SimonFerrand/BIOREACTOR/README.md

# 🧪 BIOREACTOR Projects

## 🔬 Featured Projects

### 🧫 Bioreactor Control System  
<p align="center">
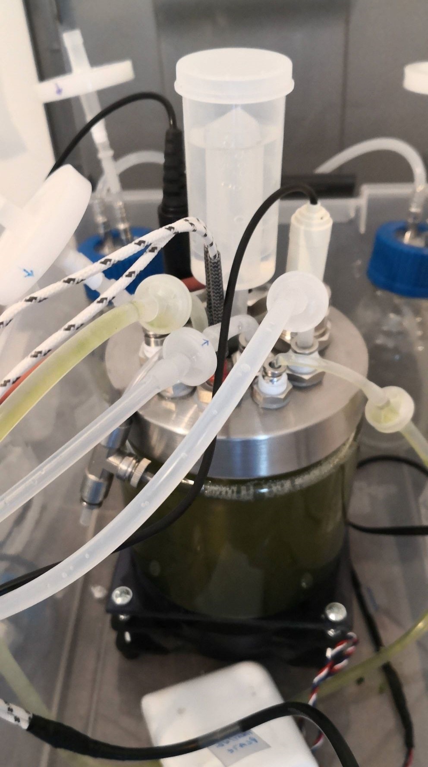
[picture p1: integration/HETEROTROPHIC/XS/docs/photo_bioreactor.jpg]
Bioreactor
  
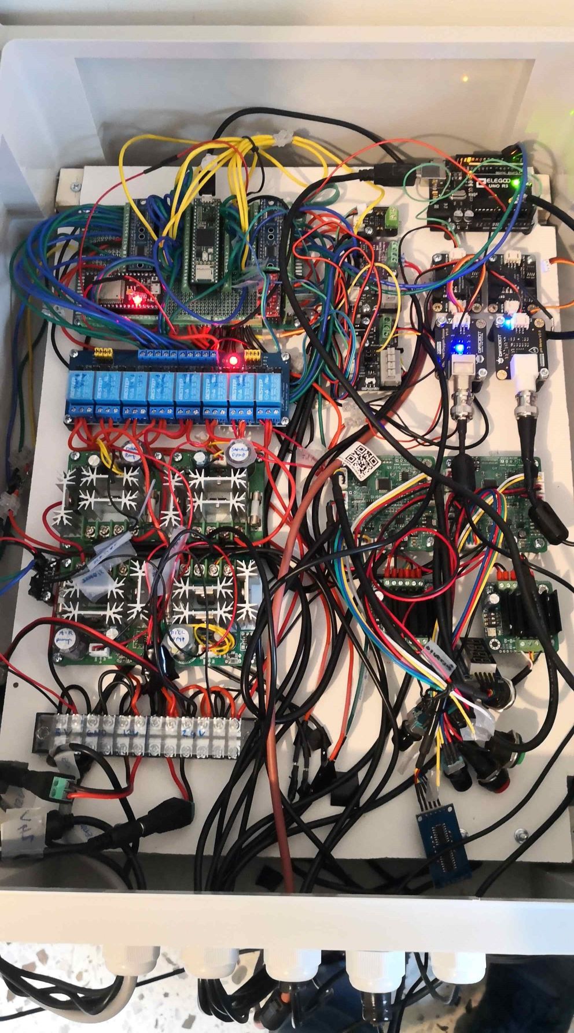
[picture p2: integration/HETEROTROPHIC/XS/docs/photo_cabinet.jpg]
Cabinet
  
</p>

<br>

A control system for managing biological processes through automated monitoring and regulation of key parameters. 

#### Key features:  
- 🧫 Sterilizable system (Autoclave 121°C, Chemical sensors)
- 🌡️ Temperature control (15-40°C)  
- ⚗️ pH regulation (5.0-8.5)  
- 💨 Dissolved oxygen management  
- 🔬 Optical density monitoring
- 📊 Real-time monitoring  
- 💾 Data logging and visualization  
- 🖥️ Web-based control interface  

📖 **[View Full Documentation →](/integration/HETEROTROPHIC/XS/README.md)**  

---

<br>

### 🌊 Water Heater Control  
<p align="center">
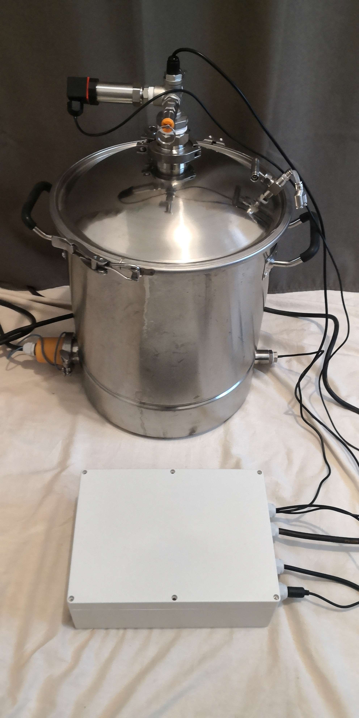
[picture p3: integration/PROCESS/WATER_HEATER/docs/photo1.jpg]
  
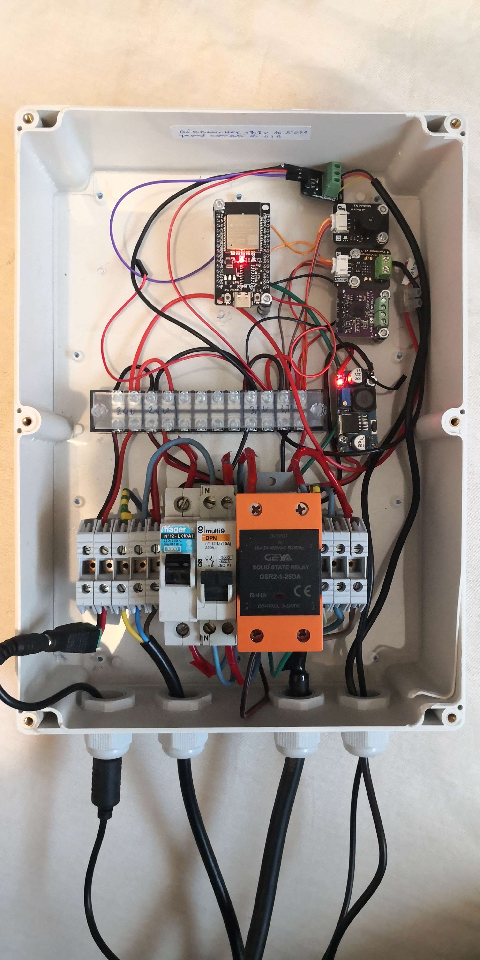
[picture p4: integration/PROCESS/WATER_HEATER/docs/photo2.jpg]
  
</p>

A water heater control system based on ESP32, designed for cleaning and sterilization processes.  

#### Key features:  
- 🎯 PID-based temperature control  
- 📈 Pressure monitoring and safety systems  
- 🔄 Clean-In-Place (CIP) automation  
- 🌐 Web interface and MQTT integration  
- 📡 Real-time data streaming  

📖 **[View Full Documentation →](/integration/PROCESS/WATER_HEATER/README.md)**  

---

<br>

## 📂 Repository Structure  

- /development: Individual component development and testing
- /integration: Complete integrated systems (featured above)
- /docs: Project documentation and resources

---

<br>

## 📝 License  
MIT License 

---
