SimonFerrand/BIOREACTOR/integration/HETEROTROPHIC/XS/requirement.txt

PID_v1
OneWire
DallasTemperature
Adafruit_MAX31865
Adafruit_MCP4725
DFRobot_PH
ArduinoJson
ezTime
Adafruit_MCP4728
NTPClient
AsyncMqttClient //  https://github.com/marvinroger/async-mqtt-client
AsyncTCP  // https://github.com/me-no-dev/AsyncTCP
Ticker
ESPAsyncTCP
ElegantOTA
CircularBuffer
ESPAsyncWebServer //https://github.com/me-no-dev/ESPAsyncWebServer
