SimonFerrand/BIOREACTOR/integration/HETEROTROPHIC/XS/docs/diagram/architectur_diagram.png

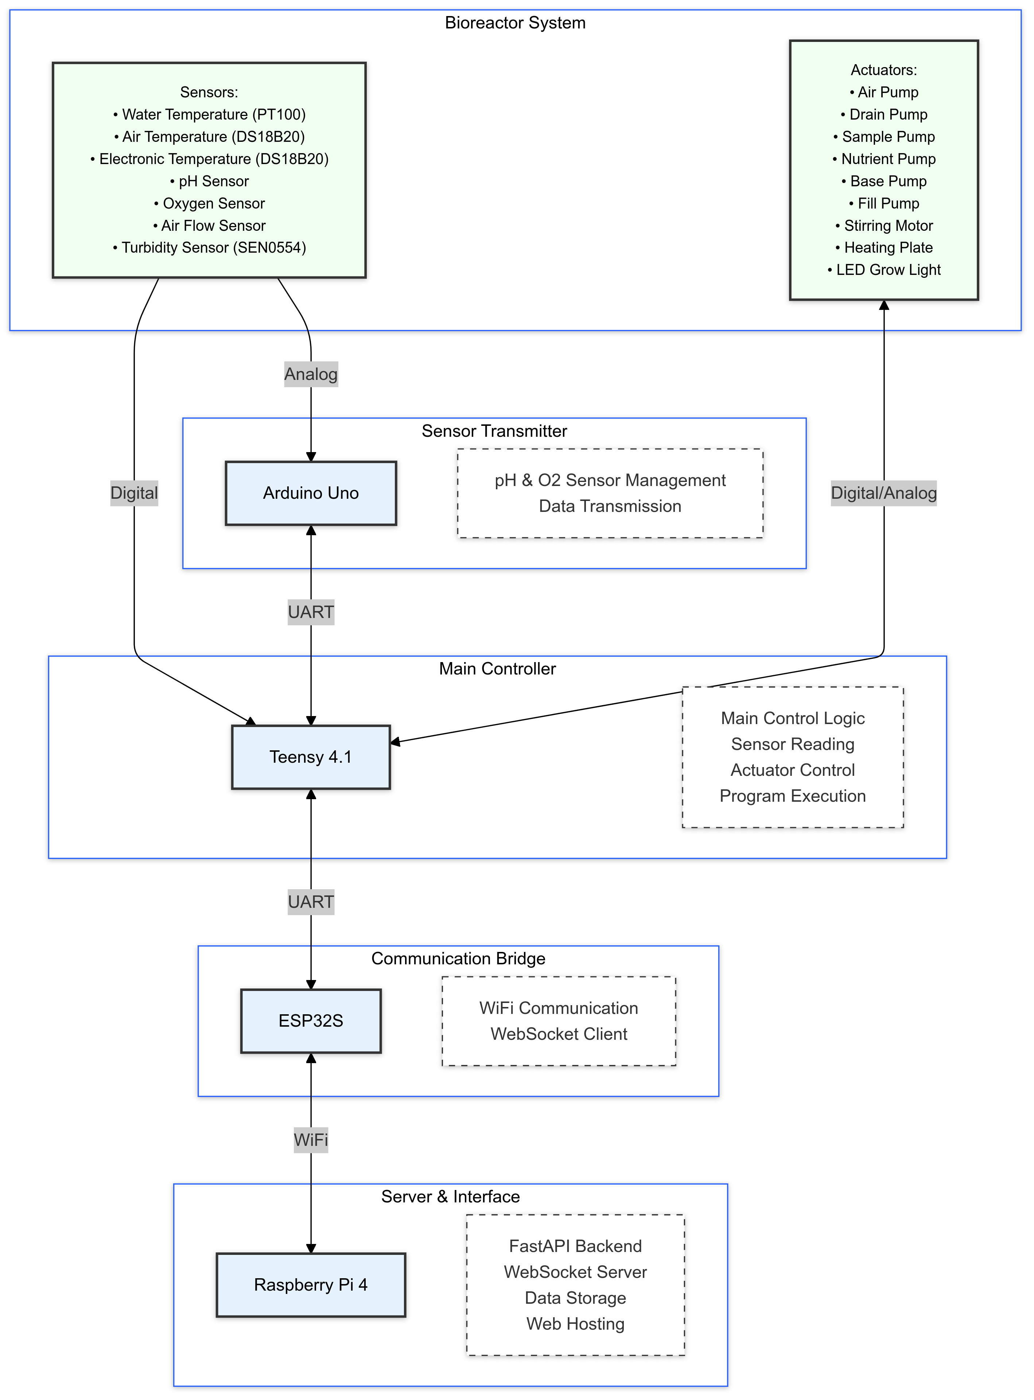
integration/HETEROTROPHIC/XS/docs/diagram/architectur_diagram.png
