SimonFerrand/BIOREACTOR/integration/PROCESS/WATER_HEATER/docs/data_page.PNG

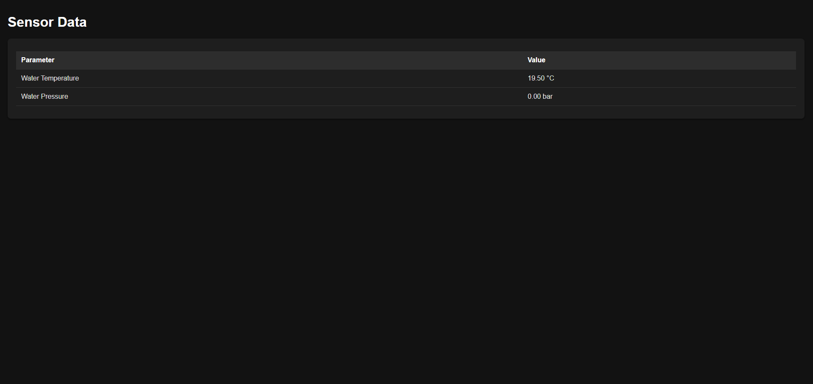
integration/PROCESS/WATER_HEATER/docs/data_page.PNG
