SimonFerrand/BIOREACTOR/integration/PROCESS/WATER_HEATER/docs/OAT_page.PNG

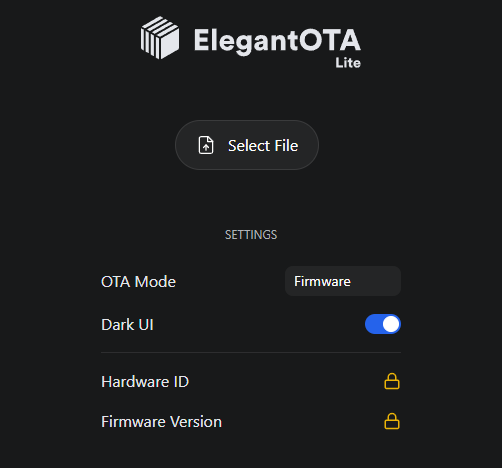
integration/PROCESS/WATER_HEATER/docs/OAT_page.PNG
