SimonFerrand/BIOREACTOR/integration/SERVER/raspberry_pi/ServerFastAPI/ServerFastAPI/architecture.png

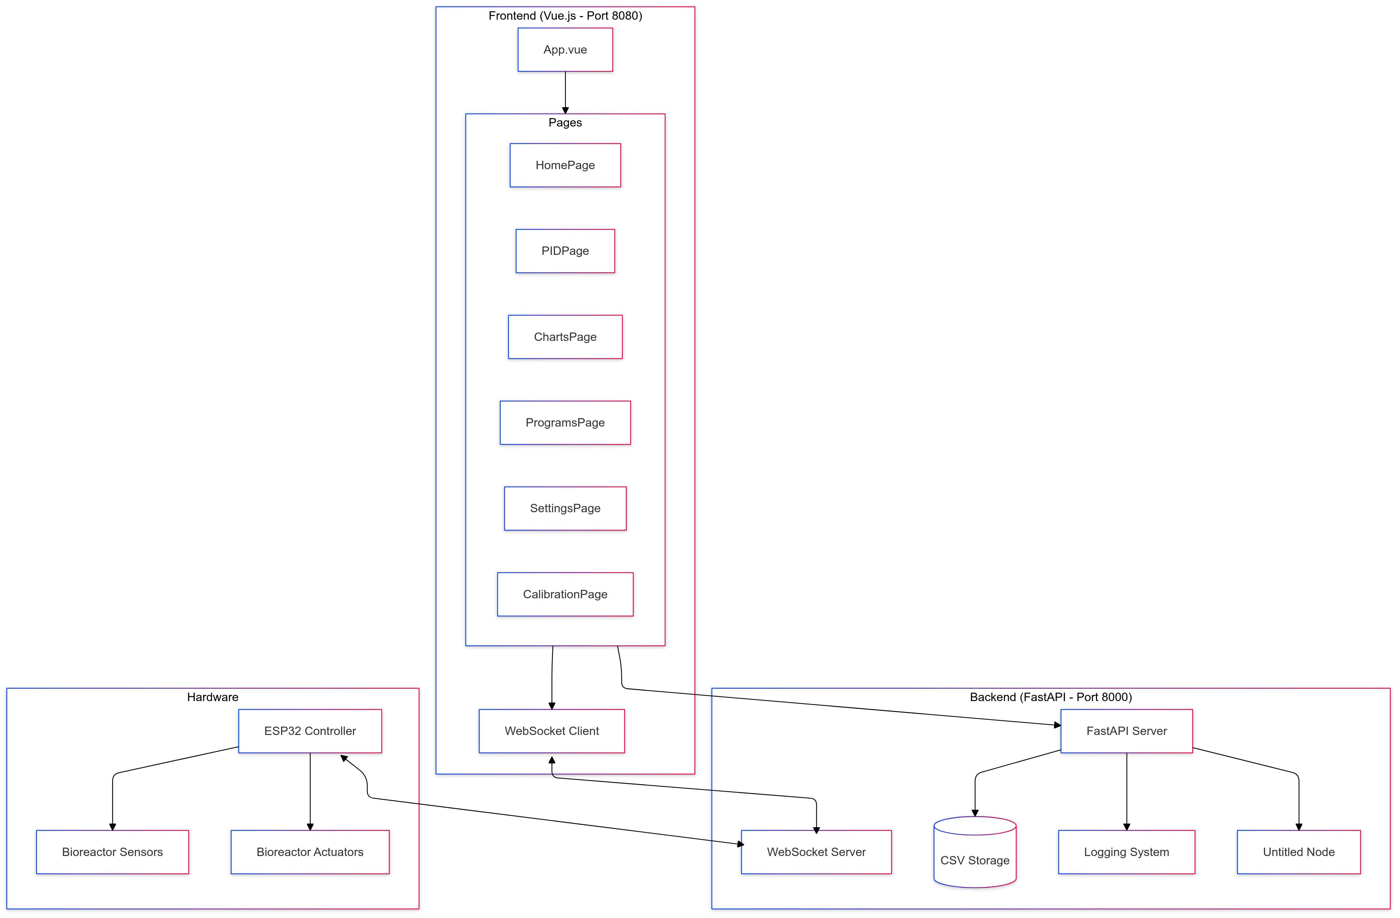
integration/SERVER/raspberry_pi/ServerFastAPI/ServerFastAPI/architecture.png
