SimonFerrand/BIOREACTOR/integration/SERVER/raspberry_pi/ServerFastAPI/install.txt

sudo groupadd sharedgroup
sudo usermod -aG sharedgroup pi
sudo chown -R pi:sharedgroup /Raspberry
sudo chmod -R 2775 /Raspberry

sudo nano /etc/samba/smb.conf
:
[Raspberry]
path = /Raspberry
writeable = yes
create mask = 0777
directory mask = 0777
public = yes
force group = sharedgroup

sudo systemctl restart smbd

npm install plotly.js-dist
pip install pandas pyarrow fastparquet

npm install plotly.js-dist --save
npm install plotly.js-dist@latest
npm install

rm -rf node_modules
rm package-lock.json
npm install

npm install webpack --save-dev
