SimonFerrand/BIOREACTOR/(threads)

Thread 1 (2024-06-07):

Problems with Apache2 Configuration and SSL Authorization

SimonFerrand, 2024-06-07:
Description:
I am facing issues with the Apache2 server configuration, specifically with SSL authorization. Despite numerous attempts, I am unable to resolve the situation. Previously, I managed to get Apache2 working with HTTPS using OpenSSL, but now I can't seem to replicate that success.

Before formatting, I was able to make Apache2 work with HTTPS, but only with OpenSSL. I had trouble properly copying the certificates to the ESP of my Arduino. Now, even though I think I have successfully installed the frontend, the authorization issues persist.

Attached is a txt file of the console showing the errors encountered.[
[cmd.txt](https://github.com/user-attachments/files/15725038/cmd.txt)
](url)

Thread 4 (2024-08-29):

Stack Overflow - SRAM too small

SimonFerrand, 2024-08-29:
I've noticed that above 63%, or at least 67% of SRAM used, there seems to be a stackoverflow problem: the Periodic Event log doesn't print all the JSON. This is problematic because the data is not saved on the server.

One of the solutions for not MinMaxing all my code and allowing me to evolve it would be to migrate to Teensy 4.1.

SimonFerrand, 2024-10-10:
Migration to the Teensy 4.1, which has significantly more SRAM than the Arduino Mega, helped resolve this stack overflow issue.

Closed 2024-10-10.

Thread 5 (2024-11-20):

Compile Arduino Sketch - Error

SimonFerrand, 2024-11-20:
Run mkdir ./build_dir
  mkdir ./build_dir
  arduino-cli compile --fqbn arduino:avr:mega --output-dir ./build_dir ./integration/arduino_mega/Main/Main.ino
  shell: /usr/bin/bash --noprofile --norc -e -o pipefail {0}
Can't open sketch: no such file or directory: /home/runner/work/BIOREACTOR/BIOREACTOR/integration/arduino_mega/Main/Main.ino
Error: Process completed with exit code 1.

=> The architecture of the file has changed
