SimonFerrand/BIOREACTOR/integration/HETEROTROPHIC/XS/teensy/Main/DCPump.h

/*
 * DCPump.h
 * This file defines a class for controlling DC pumps using PWM, a relay, and a motor speed controller.
 * The class implements the ActuatorInterface and provides methods to control the pump with a specified
 * minimum PWM value. This is useful for controlling various types of DC pumps, such as air pumps and liquid drain pumps.
 *
 * Physical modules used:
 * - Relay module
 * - PW1VA01 PWM to Voltage converter
 * - Motor speed controller
 * - DC pump (air pump or liquid drain pump)
 */

#ifndef DCPUMP_H
#define DCPUMP_H

#include "ActuatorInterface.h"
#include <Arduino.h>
#include "QuadChannelDACController.h"

class DCPump : public ActuatorInterface {
public:
    /*
     * Constructor for DCPump.
     * @param pwmPin: The pin connected to the PWM input of the pump.
     * @param relayPin: The pin connected to the relay controlling the pump's power.
     * @param minPWM: The minimum PWM value required to run the pump.
     * @param name: Identifier for the pump (for debugging purposes).
     */
    DCPump(int channel, int relayPin, int minPWM, const char* name);

    /*
     * Method to initialize the pump.
     * This method is called to set up the pump before it's first used.
     */
    void begin() override;

    /*
     * Method to control the pump.
     * @param state: Boolean indicating whether the pump should be on or off.
     * @param value: Integer value to control the speed of the pump.
     */
    void control(bool state, int value) override;

    /*
     * Method to check if the pump is on.
     * @return Boolean indicating if the pump is on.
     */
    bool isOn() const override;

    /*
     * Method to get the name of the pump.
     * @return The name of the pump.
     */
    const char* getName() const override { return _name; }

    /*
     * Method to get the volume of liquid removed by the pump.
     * @return The volume removed in liters.
     */
    float getVolumeAdded() const { return _volumeAdded; }

    /*
     * Method to reset the volume removed counter.
     */
    void resetVolumeAdded() { _volumeAdded = 0; }

    int getCurrentValue() const override;

private:
    int _channel;    
    int _relayPin;  // Relay pin
    int _minPWM;    // Minimum PWM value
    const char* _name;
    bool _status; // Track the state of the pump
    int _currentValue;
    float _volumeAdded;
    float _volumeRemoved; // Track the volume removed by the pump
    
};

#endif
