SimonFerrand/BIOREACTOR/integration/HETEROTROPHIC/XS/teensy/Main/QuadChannelDACController.h

// Development for DAC "MCP4728"

// QuadChannelDACController.h
#ifndef QUAD_CHANNEL_DAC_CONTROLLER_H
#define QUAD_CHANNEL_DAC_CONTROLLER_H

#define MCP4728_CHANNEL_A MCP4728_CHANNEL_A
#define MCP4728_CHANNEL_B MCP4728_CHANNEL_B
#define MCP4728_CHANNEL_C MCP4728_CHANNEL_C
#define MCP4728_CHANNEL_D MCP4728_CHANNEL_D

#include <Wire.h>
#include <Adafruit_MCP4728.h>

class QuadChannelDACController {
public:
    static QuadChannelDACController& getInstance();
    void begin(uint8_t address, int sdaPin, int sclPin);
    void setVoltage(uint8_t channel, uint16_t voltage);

private:
    QuadChannelDACController();
    static QuadChannelDACController* instance;
    Adafruit_MCP4728 _dac;
    TwoWire* _wire;

    uint8_t _address;
    int _sdaPin;
    int _sclPin;
};

#endif
