SimonFerrand/BIOREACTOR/integration/PROCESS/WATER_HEATER/WATER_HEATER_ESP32/WebPageBuilder.h

// WebPageBuilder.h - Génération des pages HTML
#ifndef WEB_PAGE_BUILDER_H
#define WEB_PAGE_BUILDER_H

#include <Arduino.h>
#include "DataManager.h"


class WebPageBuilder {
public:
    static String buildIndexPage(const String& deviceInfo);
    static String buildDataPage(const SensorData& data);
    static String buildConfigPage();
    static String buildProgramPage();
    
private:
    static String getHeader(const String& title);
    static String getFooter();
    static String getStyle();
    static String getScript();
};

#endif
