SimonFerrand/BIOREACTOR/development/communication/MQTT_FreeRTOS_OTA_WebControl_ESP32/MQTT_FreeRTOS_OTA_WebControl_ESP32/WebServerManager.h

// WebServerManager.h
#ifndef WEBSERVER_MANAGER_H
#define WEBSERVER_MANAGER_H

#include <WebServer.h>
#include <ElegantOTA.h>
#include <Arduino.h>
#include "DataProvider.h"
#include "config.h"
#include "Logger.h"
#include "WebPageBuilder.h"
#include "APIHandler.h"

// Forward declaration
class Logger;

class WebServerManager {
public:
    explicit WebServerManager(DataProvider& dataProvider);
    
    void begin();
    void handle();  // Called from task
    void stop();

private:
    WebServer server;
    DataProvider& dataProvider;
    TaskHandle_t serverTaskHandle;
    String allowedIP;
    unsigned long lastFailedAttempt;
    int failedAttempts;
    

    void setupRoutes();
    void setupOTA();
    static void serverTask(void* parameter);
};

#endif 
