SimonFerrand/BIOREACTOR/integration/HETEROTROPHIC/WATER_BATH/main/private_config.h

// ===== private_config.h =====
#ifndef PRIVATE_CONFIG_H
#define PRIVATE_CONFIG_H

// WiFi credentials
#define WIFI_SSID "oOo"
#define WIFI_PASSWORD "wYnXLVYW42yknz7VG4Ab25E8"

// MQTT authentication 
#define MQTT_USERNAME ""  // Leave empty if not using auth
#define MQTT_PASSWORD ""  // Leave empty if not using auth

// Future SSL/TLS Settings (commented for future use)
/*
#define USE_SSL false
#define SSL_FINGERPRINT "XX XX XX XX XX XX XX XX XX XX XX XX XX XX XX XX XX XX XX XX"
#define SSL_CERT_FILE "/cert.pem"
*/

#endif // PRIVATE_CONFIG_H
