SimonFerrand/BIOREACTOR/integration/HETEROTROPHIC/XS/teensy/Main/ErrorHandler.cpp

#include "ErrorHandler.h"
#include "Logger.h"

void ErrorHandler::handleError(const String& errorMessage) {
    Logger::log(LogLevel::ERROR, "ERROR: " + errorMessage);
    // Add error handling logic here (e.g. emergency stop)
}

void ErrorHandler::checkSensorResponses() {
    // Implement the logic to check that all sensors respond correctly
}

void ErrorHandler::checkActuatorResponses() {
    // Implement the logic to check that all actuators respond correctly
}
