SimonFerrand/BIOREACTOR/(commit log)

2024-08-19 [Stack Overflow problem solved] - Optimized string handling by using the F() macro to store string literals in Flash memory instead of SRAM. This change reduced SRAM usage from 92% to 59%, resulting 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
    [ActuatorController.cpp, AirFlowSensor.cpp, Air_pump.ino, CommandHandler.cpp, DCPump.cpp, DS18B20TemperatureSensor.cpp, DrainProgram.cpp, FermentationProgram.cpp]
2024-08-19 Optimized logging for actuators to reduce redundancy by only logging state changes and value updates, while maintaining detailed control logic
2024-08-20 Fixed errors relating to volume, PID, commandHandler in the fermentation program and added a method for obtaining all volume data
    [ActuatorController.cpp, CommandHandler.cpp, CommandHandler.h, DCPump.cpp, DCPump.h, FermentationProgram.cpp, FermentationProgram.h, PeristalticPump.cpp]
2024-08-21 Corrections and improvements to the logger, dataCollerctor and data transmission
    [CommandHandler.cpp, CommandHandler.h, Communication.cpp, Communication.h, DataCollector.cpp, DataCollector.h, FermentationProgram.h, Logger.cpp]
2024-08-22 Improving the nature of the data sent, updating the communication pipe for sending data between arduino, esp32 and raspberry
2024-08-22 Add server data for the previous commit
    [data.csv]
2024-08-23 Allow the fermentation program to stop if the nutrient pump is running
2024-08-23 Correction of the sending of initialisation data from esp to the server, correction of the esp time,
    [ESP32.ino]
2024-08-23 fermentation duration is converted into hours for the program launch command and in the logger; Correction of the missing duration in the log
    [FermentationProgram.cpp, FermentationProgram.h, Main.ino]
2024-08-26 Oxygen sensor calibration method added
2024-08-26 Improved PID adjustment
2024-08-26 Addition of a sampling method before sensor measurement for logging and sending to the server
2024-08-29 Improvement of oxygen and ph sensor classes (calibration, eeprom backup, etc.)
2024-08-29 Modification of the temperature PID to speed up heating during initialisation.
2024-09-16 Testing the Teensy 4.1 board. This board will replace the Arduino Mega because it is more powerful and has more RAM, and will avoid stackoverflow problems.
    [BTS7960_Teensy.ino, ESP32.ino, Teensy.ino, Teensy_4.1.ino]
2024-10-02 Migration from Arduino Mega to Teensy 4.1
2024-10-09 Migration from Arduino Mega to Teensy 4.1 (part II)
2024-10-10 Migrate pH and O2 sensor control to Arduino Uno, implementing serial communication with Teensy to eliminate interference and improve analogic signal integrity.
    [CommandHandler.cpp, Main.ino, OxygenSensor.cpp, OxygenSensor.h, PHSensor.cpp, PHSensor.h, PT100Sensor.cpp, SensorController.cpp]
2024-10-17 Refactored relay initialization logic after switching to new 3.3V-triggered relays, as the previous 3.3V-5V bidirectional converter failed to deliver 5V with the old relays. Replaced four 'PWM to Vol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
    [DCPump.cpp, DCPump.h, DS18B20TemperatureSensor.cpp, HeatingPlate.cpp, LEDGrowLight.cpp, Main.ino, OxygenSensor.cpp, OxygenSensor.h]
2024-10-18 Implemented startup script to automatically check and restart Bioreactor services, ensuring continuous operation and regular system updates on Raspberry Pi.
2024-10-18 Fixed DCPump to use MCP4728 DAC channels instead of PWM pins.
    [DCPump.cpp, DCPump.h, Main.ino, QuadChannelDACController.h]
2024-10-21 Update to work with Teensy.
2024-10-22 PID correction for temperature and dissolved oxygen.
    [FermentationProgram.cpp, Main.ino, PIDManager.cpp, PIDManager.h, TestsProgram.cpp]
2024-10-24 Improved pH meter code and o2 sensor calibration.
2024-10-25 Fixed communication between Teensy and Arduino for pH sensor and O2 sensor calibration.
    [CommandHandler.cpp, CommandHandler.h, Main.ino, OxygenSensor.cpp, OxygenSensor.h, PHSensor.cpp, PHSensor.h, sensor_transmitter.ino]
2024-10-29 Fixed issue with saving oxygen sensor calibration data to the sensor transmitter's EEPROM.
    [EEPROMWrapper.h, OxygenSensor.cpp, OxygenSensor.h, PHSensor.h, eeprom2.ino, eeprom3.ino, epprom.ino, sensor_transmitter.ino]
2024-10-29 Fixed data retrieval issue for temperature compensation in pH sensor calibration on the transmitter.
    [PHSensor.cpp, sensor_transmitter.ino]
2024-10-29 Improved helper and O2 data print functionality.
2024-10-31 PID Improved.
2024-10-31 fix(PID): Add input validation for sensors to prevent incorrect PID outputs affecting stirring motor speed when sensor readings are out of valid ranges or timeouts occur,
    [DCPump.cpp, FermentationProgram.h, Main.ino, PIDManager.cpp, PeristalticPump.cpp]
2024-10-31 fix(PID): Improve temperature and pH sensor validation to prevent heating errors and incorrect stirring speeds.
    [FermentationProgram.h, PIDManager.cpp]
2024-11-14 Several small changes: Addition of plots, correction of volume manager, modification of fermentation settings.
    [CommandHandler.cpp, DCPump.cpp, FermentationProgram.cpp, FermentationProgram.h, Main.ino, PIDManager.cpp, PeristalticPump.cpp, SensorController.h]
2024-11-15 feat(safety): Add heating plate monitoring to detect stuck temperature sensor & prevent overheating
    [Main.ino, SafetySystem.cpp, SafetySystem.h]
2024-11-15 Only take sample if Fermentation program is running
2024-11-15 Added 'reset volume' command to reset VolumeManager to initial conditions.
    [CommandHandler.cpp, VolumeManager.cpp, VolumeManager.h]
2024-11-15 Add getCurrentValue() method to get actuators' current setpoints; Add actuator setpoints collection to DataCollector for monitoring system state
2024-11-15 Add actuator setpoint monitoring and logging to CSV data.
2024-11-15 fix: Update SafetySystem to properly check volume levels by adding VolumeManager integration.
    [Main.ino, SafetySystem.cpp, SafetySystem.h]
2024-11-16 Real-time data visualization script for plotting bioreactor parameters from CSV logs.
    [data.csv]
2024-11-17 Updated ChartsPage to display only the latest fermentation data, added dark mode, and improved user-friendly buttons.
2024-11-20 The ESP32 now successfully establishes MQTT and HTTP connections with the Raspberry Pi server, enabling bidirectional communication for sending sensor data and receiving commands to control the biore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
2024-11-20 Reorganized the structure and architecture of the project files.
    [data.csv]
2024-11-21 Implementation of secure OTA update system for ESP32-S3 with progress monitoring, IP-based access control, and improved error handling using ElegantOTA library..
    [OTAManager.cpp, OTAManager.h, OTA_ESP32.ino, config.h]
2024-11-22 feat: Add industrial pressure sensor system with EMA filtering and advanced error detection [development]
    [PressureSensor.cpp, PressureSensor.h, PressureSensor_ESP32.ino, SafetySystem.cpp, SafetySystem.h, SensorController.cpp, SensorController.h, SensorInterface.h]
2024-12-06 feat: Implement ESP32 sensor monitoring system with MQTT, OTA and web interface [development]; Small corrections on teensy
    [APIHandler.cpp, APIHandler.h, CommandHandler.cpp, DataCollector.cpp, DataProvider.cpp, DataProvider.h, Logger.cpp, Logger.h]
2024-12-06 fix(backend): Add actuator setpoints to CSV data logging for complete system state tracking and persistence
2024-12-07 feat(WATER_BATH_esp32): Set up water_bath with MQTT, OTA, temperature monitoring and realtime web interface[integration]
2025-01-27 ESP32-based smart water bath control system with PID temperature control, MQTT connectivity, and web interface [integration]
2025-07-02 add LED driver [development]
